frankyhub/Arduino_BOT_Watschl/README.md

# Arduino_BOT Joe Watschl



[Link zur Bauanleitung](https://github.com/frankyhub/Arduino_BOT_Watschl/blob/main/Bauanleitung/Bauanleitung%20Jo%20Watschl.pdf)
