frankyhub/Arduino_BOT_Watschl/Schaltplan/Readme.md

## Schaltplan Arduino BOT Watschl
