frankyhub/Arduino_BOT_Watschl/KiCad/NANO_Bot/Readme.md

## PCB für Arduino-BOTs NANO
