frankyhub/Arduino_BOT_Watschl/Platinenhalter/Platinenhalter.stl

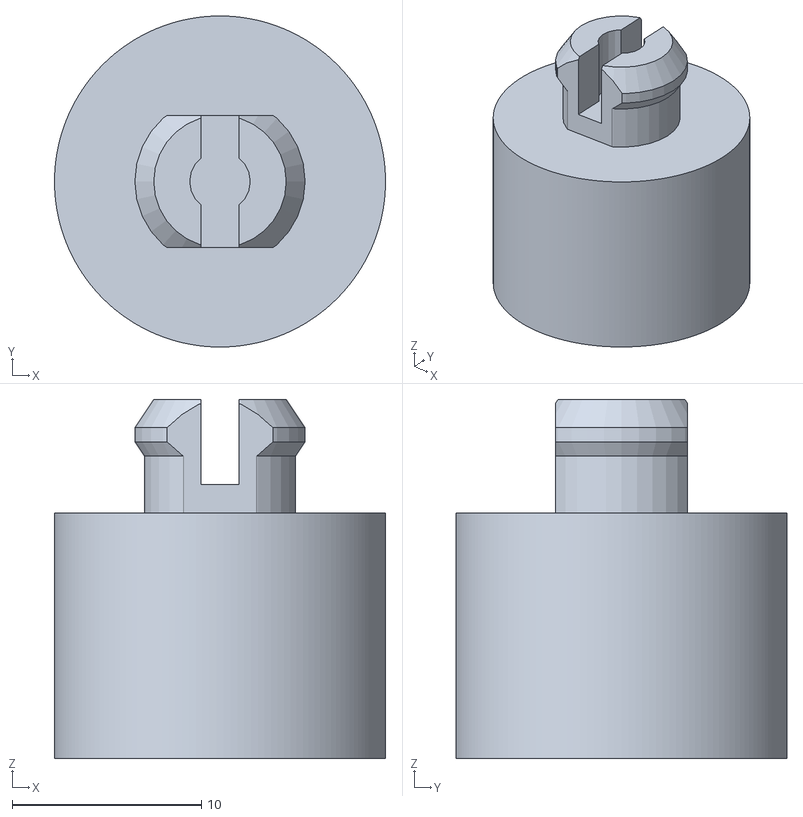
[picture p1: CAD file, 2020-10-05]
Platinenhalter/Platinenhalter.stl
17.5 x 17.5 x 19.0
