frankyhub/Arduino_BOT_Watschl/(list of files, cad)

Other CAD files:
Platinenhalter/OpenScad/PlatinenhalterV1.scad
