frankyhub/Arduino_BOT_Watschl/KiCad/NANO_Bot/NANO_Bot.kicad_pcb

## KiCad design KiCad/NANO_Bot/NANO_Bot.kicad_pcb (2020-10-03)

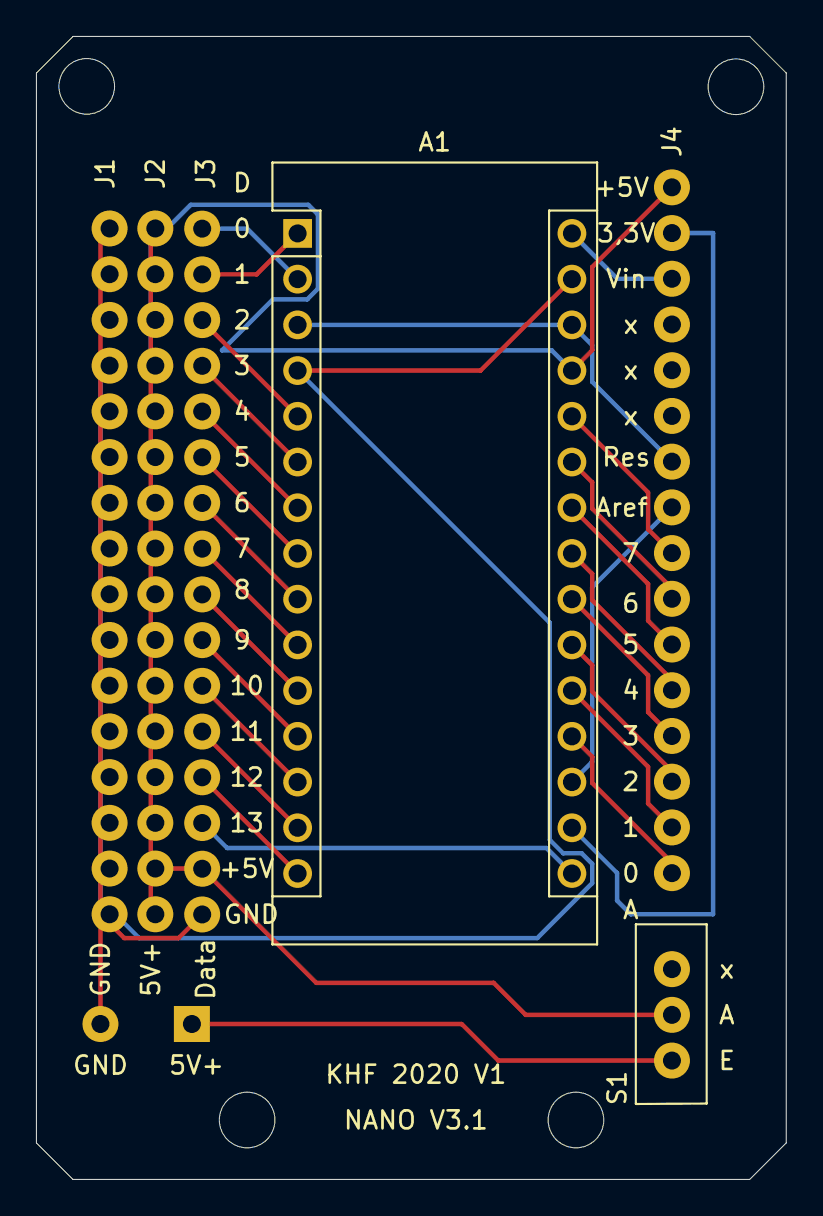
[picture p2: board NANO_Bot.kicad_pcb from above]

Board: 2 copper layers, 41.7 x 63.5 mm, 7 parts (0 on the bottom side), 29 nets.

Parts:
A1: Arduino_Nano_v3.x; Arduino_Nano
GND: 9VBat; 9VBAT_khf
J1, J2, J3, J4: NANO16PINStiftleiste; NANO_Stift_16PIN
S1: Micro_Schalter; Micro_SchalterKHF

Connections:
unnamed: A1.1, J3.2
unnamed: A1.2, J3.1
unnamed: A1.5, J3.3
unnamed: A1.6, J3.4
unnamed: A1.7, J3.5
unnamed: A1.8, J3.6
unnamed: A1.9, J3.7
unnamed: A1.10, J3.8
unnamed: A1.11, J3.9
unnamed: A1.12, J3.10
unnamed: A1.13, J3.11
unnamed: A1.14, J3.12
unnamed: A1.15, J3.13
unnamed: A1.16, J3.14
unnamed: A1.17, J4.15
unnamed: A1.18, J4.9
unnamed: A1.19, J4.1
unnamed: A1.20, J4.2
unnamed: A1.21, J4.3
unnamed: A1.22, J4.4
unnamed: A1.23, J4.5
unnamed: A1.24, J4.6
unnamed: A1.25, J4.7
unnamed: A1.26, J4.8
unnamed: A1.27, J2.1, J2.2, J2.3, J2.4, J2.5, J2.6, J2.7, J2.8, J2.9, J2.10, J2.11, J2.12, J2.13, J2.14, J2.15, J2.16, J3.15, J4.16, S1.2
unnamed: A1.3, A1.28, J4.10
unnamed: A1.4, A1.29, GND.1, J1.1, J1.2, J1.3, J1.4, J1.5, J1.6, J1.7, J1.8, J1.9, J1.10, J1.11, J1.12, J1.13, J1.14, J1.15, J1.16, J3.16
unnamed: A1.30, J4.14
unnamed: GND.2, S1.1
