frankyhub/Arduino_BOT_Watschl/Bauanleitung/Bauanleitung Jo Watschl.pdf

Bauanleitung Jo Watschl

Stückliste
1 | ABS Platte DINA4 2mm
4 | Platinenhalter (3D-Druck)
4 | Abstandshalter M3*25 Kunststoff
1 | Ardunio NANO
4 | SG90 Servo
1 | HCSR04 Ultraschallsensor
1 | LM 2596S Spannungsregler 5V
1 | 9V Batterie mit Gehäuse
| Schrauben
10 | M1.5*5
6 | M1.4*8
12 | M2*8
18 | M3*5
8 | M3*8 Senkkopf
| Muttern
6 | M1.4
12 | M2
8 | M3 selbstsichernd

Schritt 1: Die ABS-Platten lasern Verwende die Vorlagen
- 2 x BeinV1.SVG
- 1 x DeckplatteV1.SVG
- 1 x GrundplatteV1.SVG
- 2 x FussV1.SVG
- 2 x FerseV1.SVG
Link: https://github.com/frankyhub/Arduino_BOT_Watschl/tree/main/Cutter

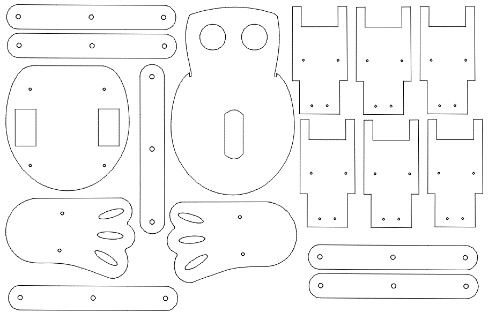
[picture p3: figure]

Laserdatei mit Reserve-Elementen (Bein und Ferse)

Schritt 2: Die Schenkel der Fersen und der Füße biegen und auf angegebenen Durchmesser aufbohren.

Füße: Beide Schenkel gleich lang, Innenmaß 37 mm

Bohrungen:

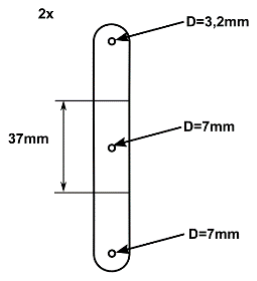
[picture p4: figure]

Ferse biegen, beide Schenkel gleich lang:

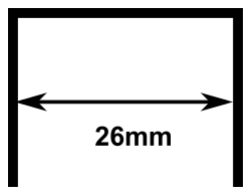
[picture p5: figure]

Bohrungen: Für die 1,5mm Bohrungen des Servos, den Servo als Bohrschablone verwenden.

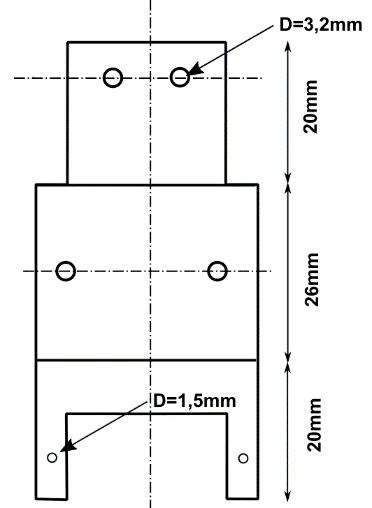
[picture p6: figure]

Schritt 3: Die Platinenhalter drucken
3D-Druckvorlage Link: https://github.com/frankyhub/openscad-Beispiele/tree/master/008%20Platinenhalter (https://github.com/frankyhub/openscad-Beispiele/tree/master/008%20Platinenhalter)

Schritt 4: Die Schrittmotoren auf die Grundplatte und an die Fersen montieren und verschrauben (alternativ kleben). Ferse und Schenkel verschrauben. Die Teile müssen beweglich bleiben, so dass der Schrittmotor den Schenkel bewegen kann.

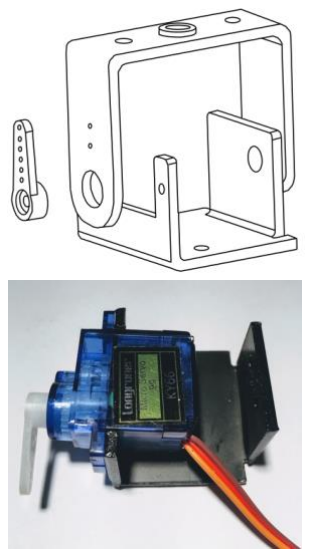
[picture p7: figure]

Schritt 5: Den Ultraschallsensor an die Deckplatte montieren (alternativ kleben).

Schritt 6: Den Arduino NANO auf die Deckplatte montieren.

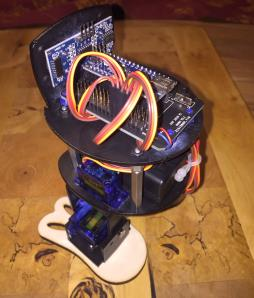
[picture p8: figure]

Schritt 7: Den Batteriehalter an die Grundplatte montieren (alternativ kleben).

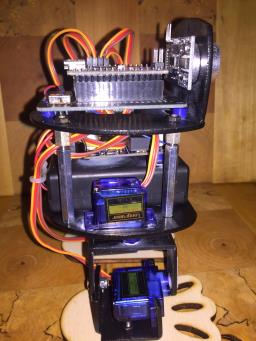
[picture p9: figure]

Schritt 8: Die Schrittmotoren, den Ultraschallsensor und den Batteriehalter nach Schaltplan verdrahten.
Link: https://github.com/frankyhub/Arduino_BOT_Watschl/tree/main/Schaltplan

Schritt 9: Das Programm in den Arduino NANO laden
Link: https://github.com/frankyhub/Arduino_BOT_Watschl/tree/main/Code

Schritt 10: Funktionstest

Fertig!

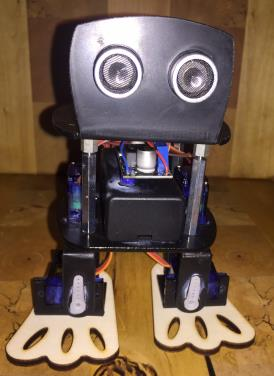
[picture p10: figure]
